sleep4at/Solar_Module/images/show1.jpg

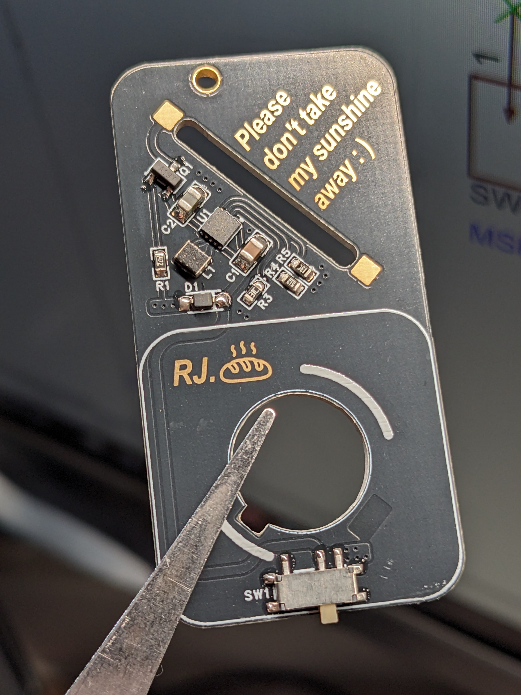
images/show1.jpg
