sleep4at/Solar_Module/images/show2.jpg

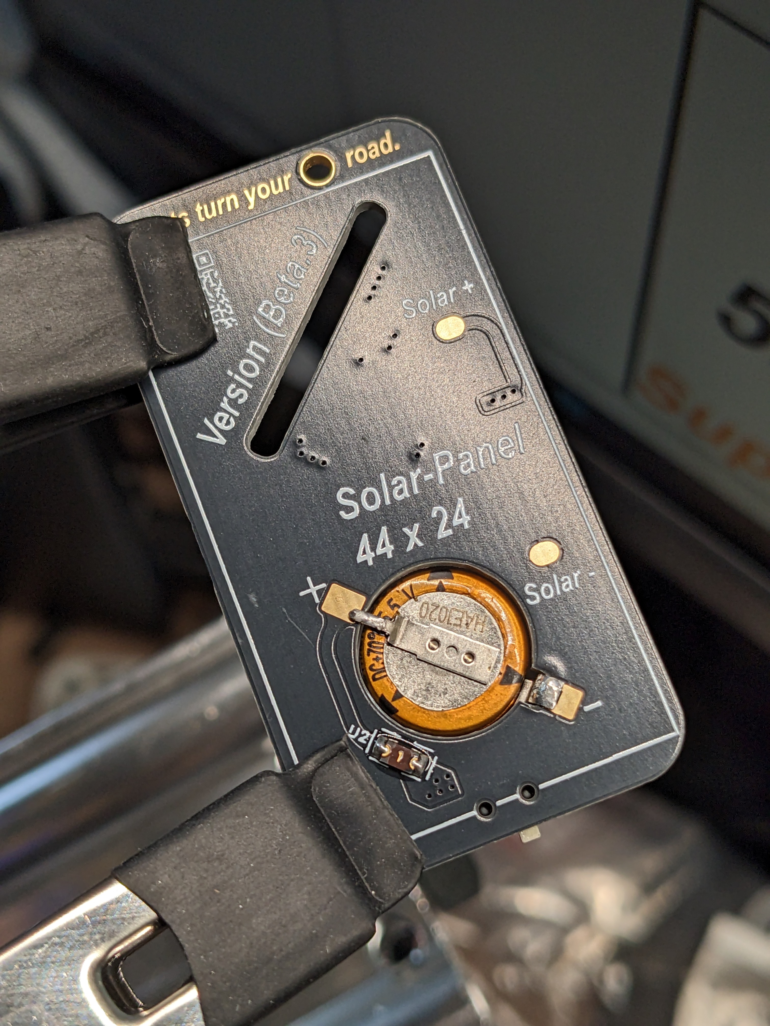
images/show2.jpg
