sleep4at/Solar_Module/images/show3.jpg

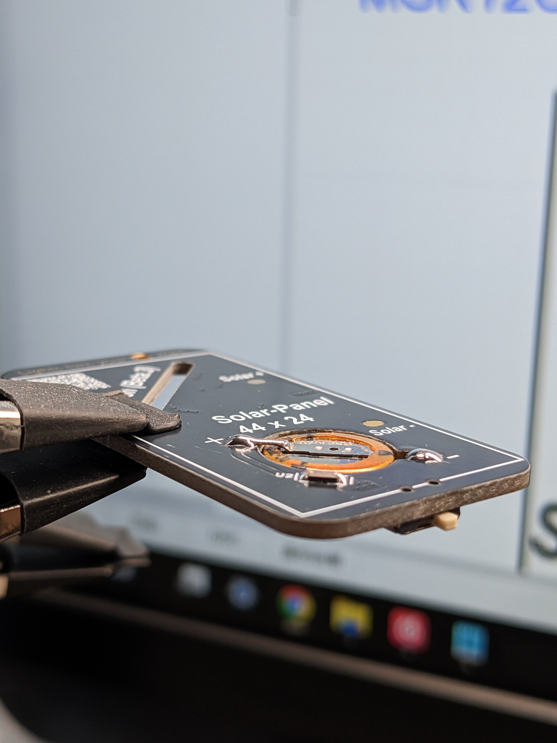
images/show3.jpg
