sleep4at/Solar_Module/images/show4.jpg

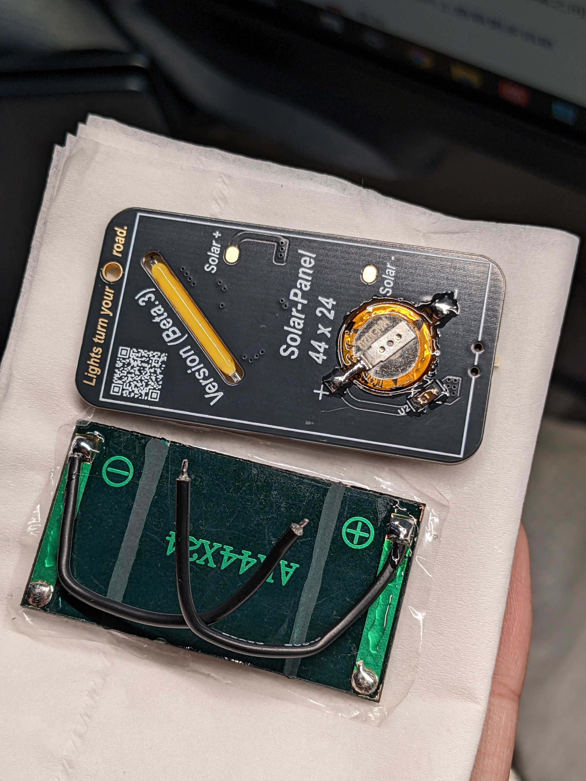
images/show4.jpg
