sleep4at/Solar_Module/images/show5.jpg

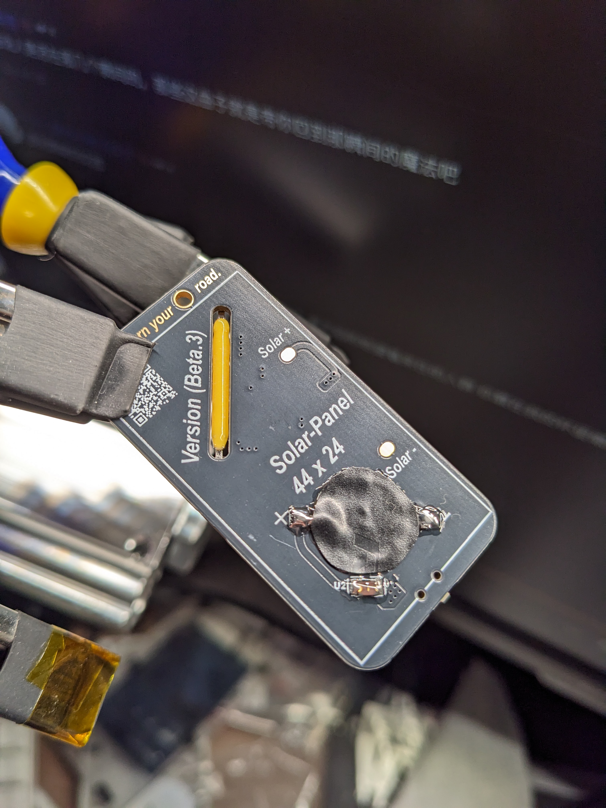
images/show5.jpg
