sleep4at/Solar_Module/images/show6.jpg

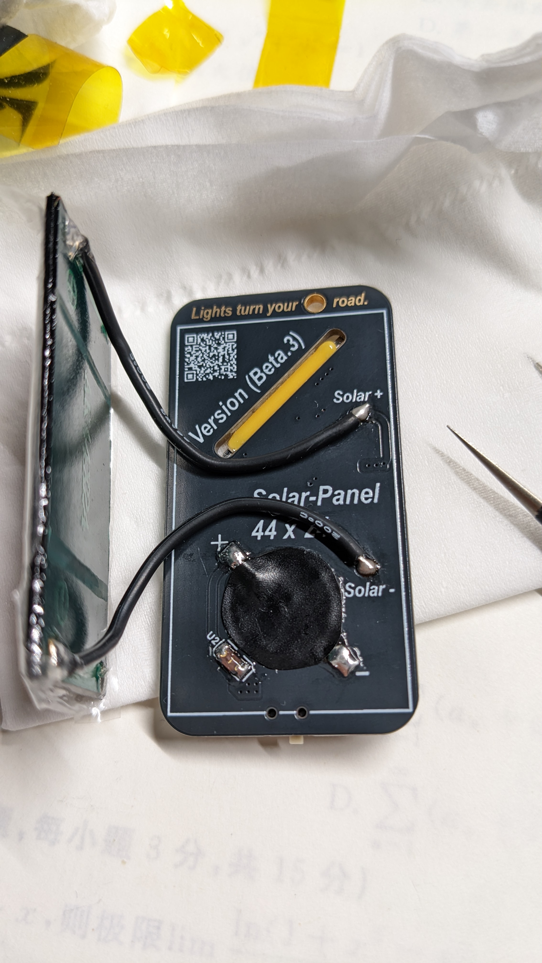
images/show6.jpg
