sleep4at/Solar_Module/images/show7.jpg

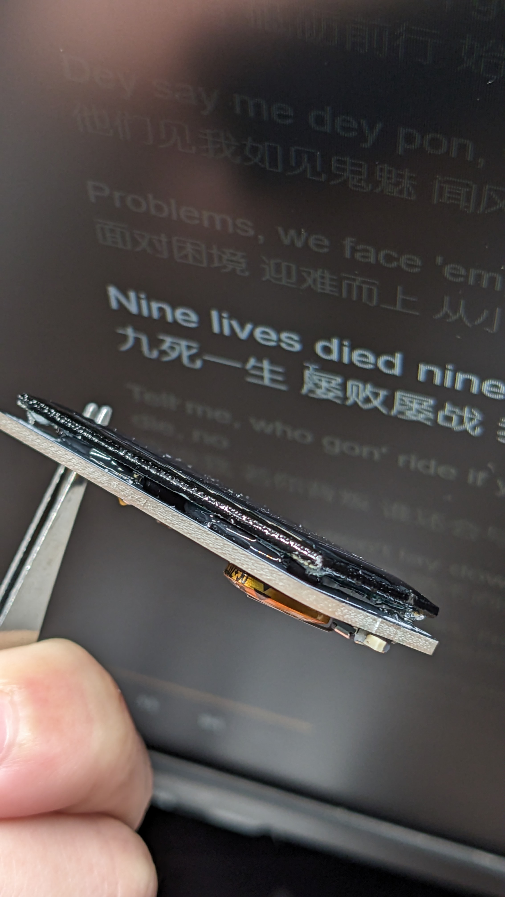
images/show7.jpg
