sleep4at/Solar_Module/images/show8.jpg

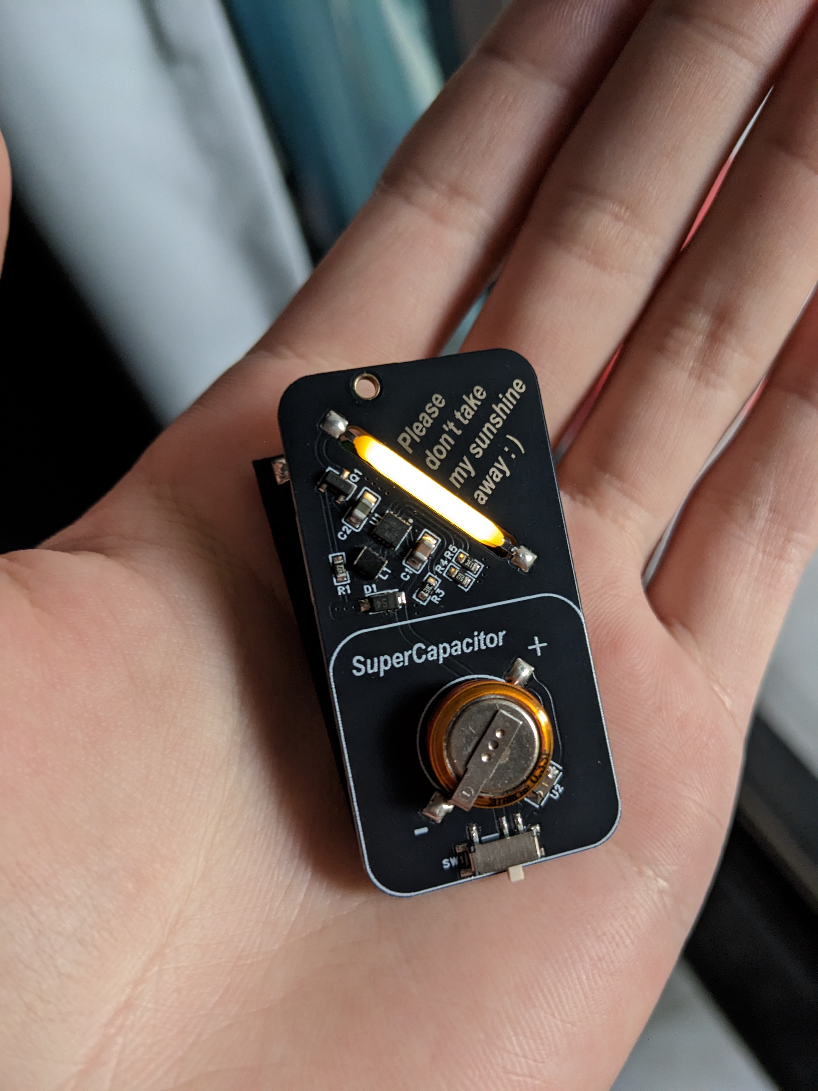
images/show8.jpg
