sleep4at/Solar_Module/images/show11.png

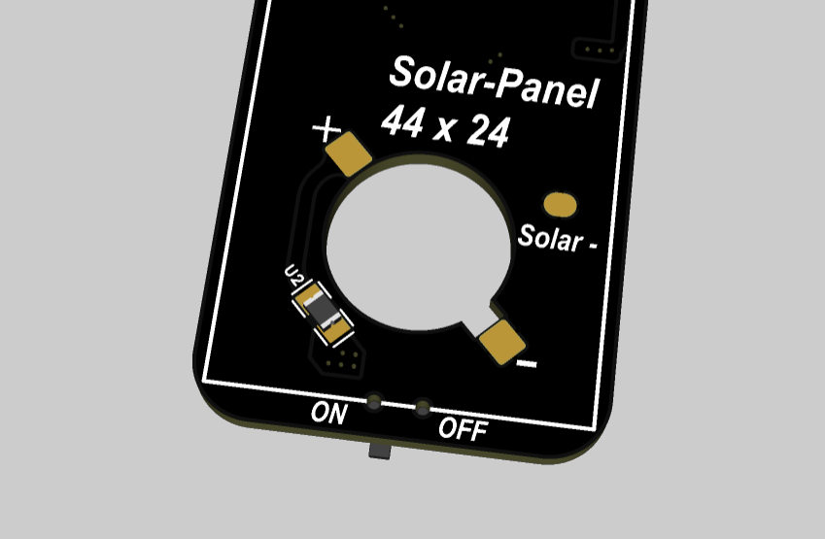
images/show11.png
