sleep4at/Solar_Module/BOM_44x24_5.5V_(Beta.2 & Beta.3 & Beta.3.1).xlsx

Quantity | Designator | Footprint | Value | Manufacturer Part | Manufacturer | Supplier Part | Supplier | 备注 | 推荐器件
1 | C1 | C0805 | 10uF | CL21A106KAYNNNE | SAMSUNG(三星) | C15850 | LCSC
1 | C2 | C0805 | 22uF | CL21A226MAQNNNE | SAMSUNG(三星) | C45783 | LCSC
1 | D1 | SOD-123_L2.8-W1.8-LS3.7-RD |  | 1N5819W | TWGMC(台湾迪嘉) | C727115 | LCSC
1 | L1 | IND-SMD_L2.5-W2.0-VLS252012CX-150M | 2.2uH | VLS252012CX-2R2M | TDK | C307867 | LCSC | 其他的也可以代替，封装尽量小，TDK这个导通电阻小一点，刚好手上有 | TDK功率电感 VLS252012CX-2R2M 2520 2.2uH ±20% 1.76A（10只） (https://item.taobao.com/item.htm?_u=n20aoqc7vo94eb&id=749370139750)
1 | Q1 | SOT-23-3_L2.9-W1.4-P1.90-LS2.6-BR |  | AO3401 | TWGMC(台湾迪嘉) | C727156 | LCSC
1 | R1 | R0603 | 4.7kΩ | 0603WAF4701T5E | UNI-ROYAL(厚声) | C23162 | LCSC
1 | R3 | R0603 | 20.5kΩ | 0603WAF2052T5E | UNI-ROYAL(厚声) | C22910 | LCSC
1 | R4 | R0603 | 1.15kΩ | 0603WAF1151T5E | UNI-ROYAL(厚声) | C22834 | LCSC
1 | R5 | R0603 | 13.3kΩ | 0603WAF1332T5E | UNI-ROYAL(厚声) | C25952 | LCSC
1 | SW1 | SW-TH_MSK12C02 |  | MSK12C02 | SHOU HAN(首韩) | C431540 | LCSC
1 | U1 | WSON-10_L2.5-W2.5-W0.50-TL-EP |  | TPS63900DSKR | TI(德州仪器) | C1518762 | LCSC
1 | U2 | F0805 |  | SMD0805-010 | 台湾陆海 | C70054 | LCSC | 自恢复保险丝选Itrip在200~300mA左右的最好，Ihold在50mA~100mA左右。 | 0805 贴片自恢复保险丝/保险管 PPTC MF-PSMF010X-2 0.1A 15V (https://item.taobao.com/item.htm?abbucket=18&id=522573198087&ns=1&priceTId=undefined&xxc=taobaoSearch)
数量 | 器件名称 |  | 器件购买链接 |  |  | 备注
1 | 5.5V 0.33F H型 超级电容器 |  | 原装正品 法拉电容 5.5V 0.33F DCS5R5334 C/H/V型 超级电容器 (https://item.taobao.com/item.htm?_u=n20aoqc7vo2ce4&id=588518502888&skuId=4180654438524) |  |  | 超级电容封装为H型
1 | 44x24mm 5V 30mA 太阳能板 |  | 小型迷你小尺寸太阳能充电板 滴胶板 电池板 光伏板 光源板 (https://item.taobao.com/item.htm?_u=n20aoqc7voa837&id=725239434511&skuId=5205047038284)
N/A | 两根较柔软的硅胶线或电子线 |  |  |  |  | 建议线材直径在1mm~2mm之间
N/A | 胶水（最好是B-7000、T-7000、硅橡胶胶水这种） |  |  |  |  | 用于固定太阳能板和焊点防水，最好是B-7000
