sleep4at/Solar_Module/(list of files, drawings)

Other design files:
Solar-Module_25-3-9.epro
