sleep4at/Solar_Module/(threads)

Thread 1 (2025-03-05):

我不太懂PCB，但是在我在对bate3PCB进行DRC检查的时候出现了这个错误，这个会影响吗

Jurmean, 2025-03-05:
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，还有我是纯小白，不懂这些，佬可以出一个零基础教程吗，我一定三连T_T

sleep4at, 2025-03-06:
> 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，还有我是纯小白，不懂这些，佬可以出一个零基础教程吗，我一定三连T_T

DRC那个错误是因为立创eda的挖槽功能不允许挖到板边，所以DRC会弹这个错误，实际不影响。
纯小白的话......我不知道你说的零基础教程是指焊接组装还是绘制PCB......
建议你直接下载gerber文件然后在嘉立创下单。然后得有一定焊接基础，焊接教程的话我过几天会以图文的方式上传到这里，很简单。
这个项目我目前是属于放任不管的状态，我这人有点喜新厌旧，旧项目没有太多价值的话我就会放一边吃灰的了，就没有补充太多东西/_ \
不过有什么问题还是可以随便问的，虽然有时候可能会忙到忽略消息。建议邮箱哈~
