sleep4at/Solar_Module/(commit log)

2025-01-22 LCEDA专业版工程文件
    [Solar-Module.epro]
2025-01-22 BOM for Beta.2 & Beta.3
    [BOM_44x24_5.5V_(Beta.2 & Beta.3).xlsx]
2025-01-22 Gerber for Beta.3
2025-03-09 new file: Assembly_Manual.pdf renamed: BOM_44x24_5.5V_(Beta.2 & Beta.3).xlsx -> BOM_44x24_5.5V_(Beta.2 & Beta.3 & Beta.3.1).xlsx new file: Gerber_Solar-Module_Beta3.1.zip modified: README.md renamed: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
    [BOM_44x24_5.5V_(Beta.2 & Beta.3 & Beta.3.1).xlsx, BOM_44x24_5.5V_(Beta.2 & Beta.3).xlsx, Solar-Module.epro, Solar-Module_25-3-9.epro]
